Kuan-Ting-Cho/Macronix_2022/README.md

# Macronix_2022
[Light-Weighted_Articulated_Rover_report](https://github.com/Kuan-Ting-Cho/Macronix_2022/blob/main/Light-Weighted_Articulated_Rover.pdf)
## 競賽影片
競賽影片 (https://www.youtube.com/watch?v=Z-dnz38k5nI)
## 評審團銅獎/新手獎
[第二十二屆旺宏金矽獎 半導體設計與應用大賽 評審團銅獎_獎狀](https://github.com/user-attachments/assets/e4c76ec9-b6a2-4254-a783-03899d4230ae)\
[第二十二屆旺宏金矽獎 半導體設計與應用大賽 評審團銅獎_獎盃](https://github.com/user-attachments/assets/028a22da-1f30-4983-8629-9ab75d08788f)\
[第二十二屆旺宏金矽獎 半導體設計與應用大賽 新手獎_獎盃](https://github.com/user-attachments/assets/c8348885-0045-4ff8-bb77-da823a88eff6)
## National Symposium on Systems Science and Engineering 2023 (NSSSE 2023)
[NSSSE 2023 conference paper](https://github.com/Kuan-Ting-Cho/Macronix_2022/blob/main/%E9%9B%99%E7%AF%80%E8%87%AA%E4%B8%BB%E5%BC%8F%E7%A7%BB%E5%8B%95%E6%A9%9F%E5%99%A8%E4%BA%BA%E4%B9%8B%E8%A8%AD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)\
[NSSSE 2023_獎狀](https://github.com/user-attachments/assets/94d212b5-d4f3-4f06-9102-8741a9e63587)
