Kuan-Ting-Cho/Macronix_2022/Macronix_2022_Light-Weighted_Articulated_Rover/Motor_Driver/src/MotorUnion/MotorUnion.cpp

#include "MotorUnion.h"
#include <unistd.h>
using namespace std;
vector<unsigned char> MotorUnion::allport = {0, 1, 2, 3, 4, 5, 6};

/**
 * Motor constructor
 *
 * @param IDArray -
 * @param MotorModelArray - Array defined the type of motor using
 */
MotorUnion::MotorUnion(const vector<unsigned char> &IDArray,
					   const vector<string> &MotorModelArray)
	: _is_deleted_thread_BG(true),
	  waiting_frequency(10)
{
	for (unsigned char i = 0; i < IDArray.size(); i++)
	{
		if (MotorModelArray.at(i) == "Mx28" || MotorModelArray.at(i) == "Mx106")
			Motor_Union.push_back(new MotorMx(IDArray.at(i), MotorModelArray.at(i)));
	}

	if (ConnectAllMotors(MotorUnion::allport))
		BGON();
}

MotorUnion::~MotorUnion()
{
	if (!_is_deleted_thread_BG)
	{
		_is_deleted_thread_BG = true;
		thread_BG->join();
		delete thread_BG;
	}

	deleteInVector(Motor_Union);
	deleteInVector(portHandler);
	deleteInVector(groupBulkRead);
	deleteInVector(groupBulkWrite);
}

template <class T>
void MotorUnion::deleteInVector(vector<T *> tmp_vector)
{
	while (!tmp_vector.empty())
	{
		delete tmp_vector.back();
		tmp_vector.pop_back();
	}
}

////////////////////////////////////////////////////////////////////////////////
///  All Motors   //////////////////////////////////////////////////////////////
////////////////////////////////////////////////////////////////////////////////
const bool MotorUnion::ConnectAllMotors(vector<unsigned char> &AllPortNumber)
{
	vector<unsigned char>::iterator it;
	for (it = AllPortNumber.begin(); it != AllPortNumber.end();)
	{
		// Set the port path
		string port_path = string("/dev/ttyUSB" + to_string(*it));
		// Initialize PortHandler & PacketHandler instance
		dynamixel::PortHandler *tmp_portHandler = dynamixel::PortHandler::getPortHandler(port_path.c_str());
		packetHandler = dynamixel::PacketHandler::getPacketHandler(2.0);
		dynamixel::GroupBulkRead *tmp_groupBulkRead = new dynamixel::GroupBulkRead(tmp_portHandler, packetHandler);
		dynamixel::GroupBulkWrite *tmp_groupBulkWrite = new dynamixel::GroupBulkWrite(tmp_portHandler, packetHandler);

		bool port_gate = false;
		for (int i = 0; i < Motor_Union.size(); i++)
		{
			if (Motor_Union.at(i)->GetMotorConnected() == false)
			{
				Motor_Union.at(i)->ConnectDynamixel(tmp_portHandler, packetHandler, tmp_groupBulkRead, tmp_groupBulkWrite);
				port_gate |= Motor_Union.at(i)->GetMotorConnected();
			}
		}
		if (port_gate == true)
		{
			it = AllPortNumber.erase(it);
			portHandler.push_back(tmp_portHandler);
			groupBulkRead.push_back(tmp_groupBulkRead);
			groupBulkWrite.push_back(tmp_groupBulkWrite);
		}
		else
		{
			++it;
			delete tmp_groupBulkWrite;
			delete tmp_groupBulkRead;
			delete tmp_portHandler;
		}
	}

	// Check every motor is connected
	bool connected = true;
	for (int i = 0; i < Motor_Union.size(); i++)
		connected &= Motor_Union.at(i)->GetMotorConnected();

	return connected;
}

const bool MotorUnion::CheckAllMotorsConnected() const
{
	bool connected = true;
	for (int i = 0; i < Motor_Union.size(); i++)
	{
		Motor_Union.at(i)->ConnectDynamixel();
		connected &= Motor_Union.at(i)->GetMotorConnected();
	}
	return connected;
}

const bool MotorUnion::CheckAllMotorsArrival() const
{
	bool arrival = true;
	for (int i = 0; i < Motor_Union.size(); i++)
	{
		arrival &= Motor_Union.at(i)->GetMotor_Arrival();
	}
	return arrival;
}

/**
 * Wait for i-th motor to arrive
 *
 * @param i - ID of the motor
 */
void MotorUnion::WaitMotorArrival(int i) const
{
	while (!Motor_Union.at(i)->GetMotor_Arrival())
	{
		if (GetAllMotorsTorqueEnable() == false)
			break;
		this_thread::sleep_for(chrono::milliseconds(waiting_frequency));
	}
}

void MotorUnion::WaitAllMotorsArrival() const
{
	while (!CheckAllMotorsArrival())
	{
		if (GetAllMotorsTorqueEnable() == false)
			break;
		this_thread::sleep_for(chrono::milliseconds(waiting_frequency));
	}
}

void MotorUnion::WaitAllMotorsArrival(const int &total_waiting_time_ms) const
{
	for (int i = 0; i < total_waiting_time_ms / waiting_frequency; i++)
	{
		if (GetAllMotorsTorqueEnable() == false)
			break;
		this_thread::sleep_for(chrono::milliseconds(waiting_frequency));
	}
}

//------------------------------------------------------------------------------//
/*
	Get All Motors Data
*/
const bool MotorUnion::GetAllMotorsTorqueEnable() const
{
	bool tmp = true;
	for (int i = 0; i < Motor_Union.size(); i++)
	{
		tmp &= GetMotor_TorqueEnable(i);
	}
	return tmp;
}

//------------------------------------------------------------------------------//
/*
	Set Motors Data
*/
void MotorUnion::SetAllMotorsOperatingMode(const unsigned char &mode) const
{
	for (int i = 0; i < Motor_Union.size(); i++)
	{
		SetMotor_Operating_Mode(i, mode);
	}
}

void MotorUnion::SetAllMotorsAngle(const float &angle) const
{
	for (int i = 0; i < Motor_Union.size(); i++)
	{
		SetMotor_Angle(i, angle);
	}
}

void MotorUnion::SetAllMotorsVelocity(const int &velocity) const
{
	for (int i = 0; i < Motor_Union.size(); i++)
	{
		SetMotor_Velocity(i, velocity);
	}
}

void MotorUnion::SetAllMotorsAccel(const int &accel) const
{
	for (int i = 0; i < Motor_Union.size(); i++)
	{
		SetMotor_Accel(i, accel);
	}
}

void MotorUnion::SetAllMotorsTorqueEnable(const bool &enable) const
{
	for (int i = 0; i < Motor_Union.size(); i++)
	{
		SetMotor_TorqueEnable(i, enable);
	}
}

////////////////////////////////////////////////////////////////////////////////
///   Motor   //////////////////////////////////////////////////////////////////
////////////////////////////////////////////////////////////////////////////////
//------------------------------------------------------------------------------//
/*
	Get Motor Data
*/
const unsigned char &MotorUnion::GetMotor_ID(const unsigned char &idx) const
{
	return Motor_Union.at(idx)->GetMotorID();
}

const bool &MotorUnion::GetMotor_Connected(const unsigned char &idx) const
{
	return Motor_Union.at(idx)->GetMotorConnected();
}

const float &MotorUnion::GetMotor_Scale2RPM(const unsigned char &idx) const
{
	return Motor_Union.at(idx)->GetMotor_Scale2RPM();
}

const float &MotorUnion::GetMotor_Scale2RPMM(const unsigned char &idx) const
{
	return Motor_Union.at(idx)->GetMotor_Scale2RPMM();
}

const short &MotorUnion::GetMotor_CenterScale(const unsigned char &idx) const
{
	return Motor_Union.at(idx)->GetMotor_CenterScale();
}

const float &MotorUnion::GetMotor_Angle(const unsigned char &idx) const
{
	return Motor_Union.at(idx)->GetMotor_Angle();
}

const int &MotorUnion::GetMotor_Velocity(const unsigned char &idx) const
{
	return Motor_Union.at(idx)->GetMotor_Velocity();
}

const int &MotorUnion::GetMotor_Accel(const unsigned char &idx) const
{
	return Motor_Union.at(idx)->GetMotor_Accel();
}

const bool &MotorUnion::GetMotor_TorqueEnable(const unsigned char &idx) const
{
	return Motor_Union.at(idx)->GetMotor_TorqueEnable();
}

const float &MotorUnion::GetMotor_PresentAngle(const unsigned char &idx) const
{
	return Motor_Union.at(idx)->GetMotor_PresentAngle();
}

const float &MotorUnion::GetMotor_PresentVelocity(const unsigned char &idx) const
{
	return Motor_Union.at(idx)->GetMotor_PresentVelocity();
}

const float &MotorUnion::GetMotor_PresentTorque(const unsigned char &idx) const
{
	return Motor_Union.at(idx)->GetMotor_PresentTorque();
}

//------------------------------------------------------------------------------//
/*
	Set Motor Data
*/
void MotorUnion::SetMotor_Operating_Mode(const unsigned char &idx, char mode) const // can't set mode online
{
	// Motor_Union.at(idx)->SetMotor_TorqueEnable(false);
	// this_thread::sleep_for(chrono::milliseconds(50));
	Motor_Union.at(idx)->SetMotor_Operating_Mode(mode);
	// Motor_Union.at(idx)->WriteMode(mode);
	// this_thread::sleep_for(chrono::milliseconds(50));
	// Motor_Union.at(idx)->SetMotor_TorqueEnable(true);
}

void MotorUnion::SetMotor_CenterScale(const unsigned char &idx, const short &motor_center_scale) const
{
	Motor_Union.at(idx)->SetMotor_CenterScale(motor_center_scale);
}

void MotorUnion::SetMotor_Angle(const unsigned char &idx, const float &angle) const
{
	Motor_Union.at(idx)->SetMotor_Angle(angle);
}

void MotorUnion::SetMotor_Velocity(const unsigned char &idx, const int &velocity) const
{
	Motor_Union.at(idx)->SetMotor_Velocity(velocity);
}

void MotorUnion::SetMotor_Accel(const unsigned char &idx, const int &accel) const
{
	Motor_Union.at(idx)->SetMotor_Accel(accel);
}

void MotorUnion::SetMotor_TorqueEnable(const unsigned char &idx, const bool &enable) const
{
	Motor_Union.at(idx)->SetMotor_TorqueEnable(enable);
}

void MotorUnion::SetMotor_AngleandVelocity(const unsigned char &idx, const float &angle, const int &velocity) const
{
	Motor_Union.at(idx)->SetMotor_Velocity(velocity);
	Motor_Union.at(idx)->SetMotor_Angle(angle);
}

////////////////////////////////////////////////////////////////////////////////
///   Background   /////////////////////////////////////////////////////////////
////////////////////////////////////////////////////////////////////////////////
void MotorUnion::BGON()
{
	_is_deleted_thread_BG = false;
	thread_BG = new thread(&MotorUnion::BGReadWrite, this);
}

void MotorUnion::BGReadWrite()
{
	while (!_is_deleted_thread_BG)
	{
		WriteData();
		ReadData();
		this_thread::sleep_for(chrono::milliseconds(1));
	}
}

void MotorUnion::WriteData() const
{
	// Add parameters
	bool is_Write = false;
	for (int i = 0; i < Motor_Union.size(); i++)
		is_Write |= Motor_Union.at(i)->WriteData();

	// Write to motor
	if (is_Write)
	{
		for (int i = 0; i < groupBulkWrite.size(); i++)
		{
			int dxl_comm_result = groupBulkWrite.at(i)->txPacket();
			if (dxl_comm_result != COMM_SUCCESS)
				printf("%s\n", packetHandler->getTxRxResult(dxl_comm_result));
			groupBulkWrite.at(i)->clearParam();
		}
	}
}

void MotorUnion::ReadData() const
{
	// Add parameters
	for (int i = 0; i < Motor_Union.size(); i++)
		Motor_Union.at(i)->AddParam();

	// Read Data
	for (int i = 0; i < groupBulkRead.size(); i++)
	{
		int dxl_comm_result = groupBulkRead.at(i)->txRxPacket();
		if (dxl_comm_result != COMM_SUCCESS)
			printf("%s\n", packetHandler->getTxRxResult(dxl_comm_result));
	}

	// Record to Motor
	for (int i = 0; i < Motor_Union.size(); i++)
		Motor_Union.at(i)->ReadData();

	// clear parameters
	for (int i = 0; i < groupBulkRead.size(); i++)
		groupBulkRead.at(i)->clearParam();
}

const int &MotorUnion::Set_Velocity(int id, int mode, bool enable, int velocity)
{
	SetAllMotorsOperatingMode(1); // need to set mode on wizard 2.0 !!!!!!!!!!!!!!!!!!!!!!!!!!

	usleep(1000);

	SetMotor_TorqueEnable(id, enable);
	usleep(1000);

	SetMotor_Velocity(id, velocity);

	usleep(1000);

	return GetMotor_Velocity(id);
}

int MotorUnion::Leg_id(int id)
{

	int arr[] = {0, 2, 4, 6, 8}; // key in current motor id
	int n = sizeof(arr) / sizeof(arr[0]);
	int i = 0;
	int Leg_id;
	while (i < n)
	{
		if (arr[i] == id)
		{
			Leg_id = i;
			break;
		}
		else
		{
			i++;
		}
	}
	return Leg_id;
}

int *MotorUnion::ConvertToASCII(string s)
{
	int a;
	int *array = new int[s.length()];
	for (int i = 0; i < s.length(); i++)
	{
		a = s[i];
		array[i] = a;
	}
	return array;
}

void MotorUnion::Stop()
{
	cout << "Stop. " << endl;
	Set_Velocity(Leg_id(0), 1, 1, 0);
	Set_Velocity(Leg_id(2), 1, 1, 0);
	Set_Velocity(Leg_id(4), 1, 1, 0);
	Set_Velocity(Leg_id(6), 1, 1, 0);
	Set_Velocity(Leg_id(8), 1, 1, 0);
	sleep(1);
}

void MotorUnion::Change_angle(int Angle, int Velocity)
{

	switch (Angle)
	{
	case 49:
		cout << "Open center_angle. " << endl;
		Set_Velocity(Leg_id(8), 1, 1, Velocity);
		Set_Velocity(Leg_id(0), 1, 1, 15);
		Set_Velocity(Leg_id(2), 1, 1, -15);
		Set_Velocity(Leg_id(4), 1, 1, -15);
		Set_Velocity(Leg_id(6), 1, 1, 15);
		break;
	case 50:
		// cout << "Change angle to '" << (Angle - 48) * 10 << "' degrees." << endl;
		cout << "Close center_angle. " << endl;
		Set_Velocity(Leg_id(8), 1, 1, -Velocity);
		Set_Velocity(Leg_id(0), 1, 1, -15);
		Set_Velocity(Leg_id(2), 1, 1, 15);
		Set_Velocity(Leg_id(4), 1, 1, 15);
		Set_Velocity(Leg_id(6), 1, 1, -15);
		break;
	case 51:
		// cout << "Change angle to '" << (Angle - 48) * 10 << "' degrees." << endl;
		cout << "Close center_angle. " << endl;
		Set_Velocity(Leg_id(8), 1, 1, -Velocity);
		Set_Velocity(Leg_id(0), 1, 1, 0);
		Set_Velocity(Leg_id(2), 1, 1, 0);
		Set_Velocity(Leg_id(4), 1, 1, 50);
		Set_Velocity(Leg_id(6), 1, 1, -50);
		break;
	default:
		break;
	}
}

void MotorUnion::Change_cen_angle(int Angle, int Velocity)
{

	switch (Angle)
	{
	case 1:
		cout << "Open center_angle. " << endl;
		Set_Velocity(Leg_id(8), 1, 1, Velocity);
		break;
	case 2:
		// cout << "Change angle to '" << (Angle - 48) * 10 << "' degrees." << endl;
		cout << "Close center_angle. " << endl;
		Set_Velocity(Leg_id(8), 1, 1, -Velocity);
	default:
		break;
	}
}

void MotorUnion::TurnRight(int Velocity)
{
	cout << "Turn right. " << endl;
	Set_Velocity(Leg_id(0), 1, 1, Velocity);
	Set_Velocity(Leg_id(2), 1, 1, Velocity);
	Set_Velocity(Leg_id(4), 1, 1, Velocity);
	Set_Velocity(Leg_id(6), 1, 1, Velocity);
}

void MotorUnion::TurnRight_withtime(int Velocity, int time)
{
	cout << "Turn right. " << endl;
	Set_Velocity(Leg_id(0), 1, 1, Velocity);
	Set_Velocity(Leg_id(2), 1, 1, Velocity);
	Set_Velocity(Leg_id(4), 1, 1, Velocity);
	Set_Velocity(Leg_id(6), 1, 1, Velocity);
	sleep(time);
	Set_Velocity(Leg_id(0), 1, 1, 0);
	Set_Velocity(Leg_id(2), 1, 1, 0);
	Set_Velocity(Leg_id(4), 1, 1, 0);
	Set_Velocity(Leg_id(6), 1, 1, 0);
	Set_Velocity(Leg_id(8), 1, 1, 0);
	sleep(1);
}

void MotorUnion::TurnLeft(int Velocity)
{
	cout << "Turn left. " << endl;
	Set_Velocity(Leg_id(0), 1, 1, -Velocity);
	Set_Velocity(Leg_id(2), 1, 1, -Velocity);
	Set_Velocity(Leg_id(4), 1, 1, -Velocity);
	Set_Velocity(Leg_id(6), 1, 1, -Velocity);
}

void MotorUnion::GoStraight(int Velocity)
{
	cout << "Go straight. " << endl;
	Set_Velocity(Leg_id(0), 1, 1, Velocity);
	Set_Velocity(Leg_id(2), 1, 1, -Velocity);
	Set_Velocity(Leg_id(4), 1, 1, Velocity);
	Set_Velocity(Leg_id(6), 1, 1, -Velocity);
}

void MotorUnion::GoBack(int Velocity)
{
	cout << "Go back. " << endl;
	Set_Velocity(Leg_id(0), 1, 1, -Velocity);
	Set_Velocity(Leg_id(2), 1, 1, Velocity);
	Set_Velocity(Leg_id(4), 1, 1, -Velocity);
	Set_Velocity(Leg_id(6), 1, 1, Velocity);
}

void MotorUnion::Individual(int Front_vel, int Back_vel)
{
	cout << "Individual. " << endl;
	Set_Velocity(Leg_id(0), 1, 1, -Front_vel);
	Set_Velocity(Leg_id(2), 1, 1, Front_vel);
	Set_Velocity(Leg_id(4), 1, 1, -Back_vel);
	Set_Velocity(Leg_id(6), 1, 1, Back_vel);
}

void MotorUnion::MotorUnion::Sync_Drive(int Velocity, int time)
{

	cout << "Go straight. " << endl;
	Set_Velocity(Leg_id(0), 1, 1, Velocity);
	Set_Velocity(Leg_id(2), 1, 1, -Velocity);
	Set_Velocity(Leg_id(4), 1, 1, Velocity);
	Set_Velocity(Leg_id(6), 1, 1, -Velocity);
	sleep(time);
	Set_Velocity(Leg_id(0), 1, 1, 0);
	Set_Velocity(Leg_id(2), 1, 1, 0);
	Set_Velocity(Leg_id(4), 1, 1, 0);
	Set_Velocity(Leg_id(6), 1, 1, 0);
	sleep(1);
}
