Kuan-Ting-Cho/Macronix_2022/Macronix_2022_Light-Weighted_Articulated_Rover/Motor_Driver/src/Car_Manual_UI.cpp

#include <termio.h>
#include <stdio.h>
#include <unistd.h>
#include <iostream>
#include <fstream>

using namespace std;
int scanKeyboard()
{

    int in;
    struct termios new_settings;
    struct termios stored_settings;
    tcgetattr(STDIN_FILENO, &stored_settings);
    new_settings = stored_settings;
    new_settings.c_lflag &= (~ICANON);
    new_settings.c_cc[VTIME] = 0;
    tcgetattr(STDIN_FILENO, &stored_settings);
    new_settings.c_cc[VMIN] = 1;
    tcsetattr(STDIN_FILENO, TCSANOW, &new_settings);

    in = getchar();

    tcsetattr(STDIN_FILENO, TCSANOW, &stored_settings);
    return in;
}

int *convertToASCII(string s)
{
    int a;
    int *array = new int[s.length()];
    for (int i = 0; i < s.length(); i++)
    {
        a = s[i];
        array[i] = a;
    }
    return array;
}

int main(int argc, char *argv[])
{
    fstream test;
    string Command;
    string Function_Key1 = "l";
    string Function_Key2 = "n";
    string list;
    int Line = 0;
    while (1)
    {
        test.open("/home/potter/2022WonHon/Motor_Driver/src/test.txt", ios::in | ios::out | ios::app);
        cin >> Command;
        if (Command == Function_Key1)
        {
            while (test.peek() != EOF)
            {
                getline(test, list);
                cout << Line + 1 << ". " << list << endl;
                Line++;
            }
            if (Line == 0) // if no command in test.txt
            {
                cout << "No any command." << endl;
            }
        }
        else if (Command == Function_Key2)
        {
            test.close();
            Line = 0; // must set 0 when test.txt was closed!
            test.open("/home/potter/2022WonHon/Motor_Driver/src/test.txt", ios::out | ios::trunc);
        }
        else
        {
            test << Command;
            test << "\n";
        }
        test.close();
    }
}

/*int *ControlButton()
{
    int *array = new int[2];
    array[0] = scanKeyboard();
    array[1] = scanKeyboard();
    return array;
}

int main(int argc, char *argv[]) {


  while(1){
    int* arr=ControlButton();
    printf("\n%d\n",*arr);
    printf("%d\n",*(arr+1));
    delete[] arr;
  }

}*/
